UBIEEE/micromouse_pcb_team_2023/hardware/pcb/micromouse.kicad_pcb

## KiCad design hardware/pcb/micromouse.kicad_pcb (2024-01-07)

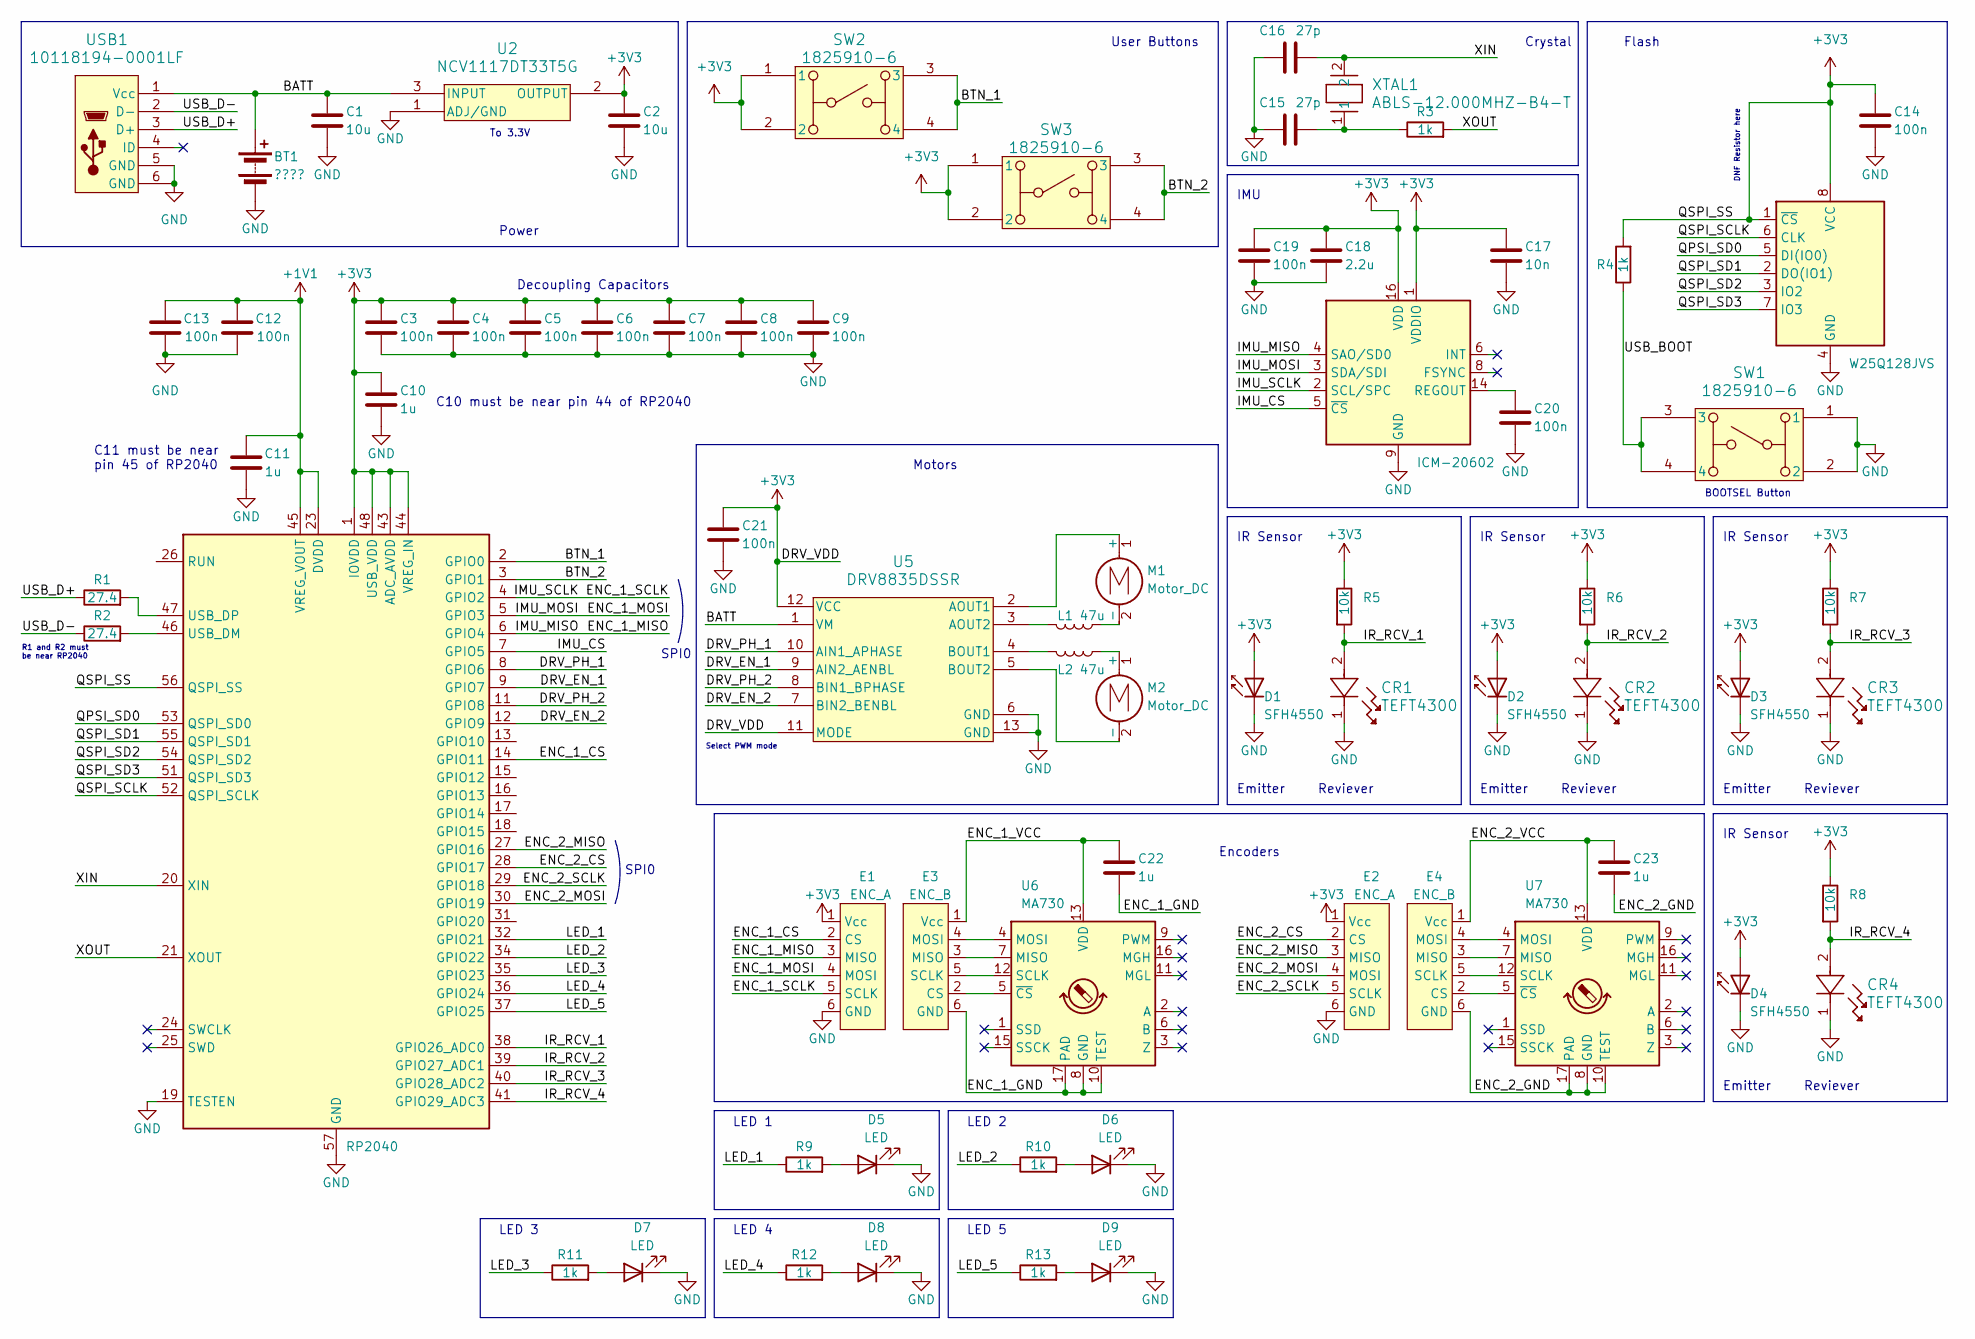
[picture p1: schematic micromouse.kicad_sch]

Parts:
BT1: ????; CONN_B2B-ZRLFSN_JST
C1, C2: 10u; CAP_GRM21_MUR
C3, C4, C5, C6, C7, C8, C9, C12, C13, C14, C19, C20, C21: 100n; CAP_GRM155_MUR
C10, C11, C22, C23: 1u; CAP_GRM155_MUR
C15, C16: 27p; CAP_GCM155_MUR
C17: 10n; CAP_GRM1885_1P6XP8_MUR
C18: 2.2u; CAP_GRM155_MUR
CR1, CR2, CR3, CR4: TEFT4300
D1, D2, D3, D4: SFH4550
D5, D6, D7, D8, D9: LED; LED_LTST-C191_LTO
E1: ENC_A; ENC_1_A
E2: ENC_A; ENC_2_A
E3: ENC_B; ENC_1_B
E4: ENC_B; ENC_2_B
L1, L2: 47u; IND_BOURNS_SRR4028
M1, M2: Motor_DC; CONN_B2B-ZRLFSN_JST
R1, R2: 27.4; RES_RC0402_YAG
R3, R4, R9, R10, R11, R12, R13: 1k; RES_RC0402_YAG
R5, R6, R7, R8: 10k; RES_RC0402_YAG
SW1, SW2, SW3: 1825910-6; SW4_1825910-B_TEC
U1: RP2040; QFN-56-1EP_7x7mm_P0.4mm_EP3.2x3.2mm
U2: NCV1117DT33T5G; DPAK-3_ONS
U3: W25Q128JVS; SOIC-8_5.23x5.23mm_P1.27mm
U4: ICM-20602; LGA-16_3x3mm_P0.5mm_LayoutBorder3x5y
U5: DRV8835DSSR; DSS0012A
U6, U7: MA730; QFN-16-1EP_3x3mm_P0.5mm_EP1.75x1.75mm
USB1: 10118194-0001LF; CONN_10118194-0001LF_AMP
XTAL1: ABLS-12.000MHZ-B4-T; XTAL_ABLS_ABR

Connections:
+1V1: C11.2, C12.2, C13.2, U1.23 (DVDD), U1.45 (VREG_VOUT), U1.50 (DVDD)
+3V3: C2.1, C3.1, C4.1, C5.1, C6.1, C7.1, C8.1, C9.1, C10.1, C14.1, C17.1, C18.1, C19.1, C21.1, D1.2 (A), D2.2 (A), D3.2 (A), D4.2 (A), E1.1 (Vcc), E2.1 (Vcc), R4.2, R5.1, R6.1, R7.1, R8.1, SW2.1, SW2.2, SW3.1, SW3.2, U1.1 (IOVDD), U1.10 (IOVDD), U1.22 (IOVDD), U1.33 (IOVDD), U1.42 (IOVDD), U1.43 (ADC_AVDD), U1.44 (VREG_IN), U1.48 (USB_VDD), U1.49 (IOVDD), U1.56 (QSPI_SS), U2.2 (OUTPUT), U3.1 (~CS), U3.8 (VCC), U4.1 (VDDIO), U4.16 (VDD), U5.11 (MODE), U5.12 (VCC)
/BATT: BT1.1 (+), C1.1, U2.3 (INPUT), U5.1 (VM), USB1.1 (Vcc)
/BTN_1: SW2.3, SW2.4, U1.2 (GPIO0)
/BTN_2: SW3.3, SW3.4, U1.3 (GPIO1)
/DRV_EN_1: U1.9 (GPIO7), U5.9 (AIN2_AENBL)
/DRV_EN_2: U1.12 (GPIO9), U5.7 (BIN2_BENBL)
/DRV_PH_1: U1.8 (GPIO6), U5.10 (AIN1_APHASE)
/DRV_PH_2: U1.11 (GPIO8), U5.8 (BIN1_BPHASE)
/ENC_1_CS: E1.2 (CS), U1.14 (GPIO11)
/ENC_1_GND: C22.2, E3.6 (GND), U6.8 (GND), U6.10 (TEST), U6.17 (PAD)
/ENC_1_MISO: E1.3 (MISO), U1.6 (GPIO4), U4.4 (SAO/SD0)
/ENC_1_MOSI: E1.4 (MOSI), U1.5 (GPIO3), U4.3 (SDA/SDI)
/ENC_1_SCLK: E1.5 (SCLK), U1.4 (GPIO2), U4.2 (SCL/SPC)
/ENC_1_VCC: C22.1, E3.1 (Vcc), U6.13 (VDD)
/ENC_2_CS: E2.2 (CS), U1.28 (GPIO17)
/ENC_2_GND: C23.2, E4.6 (GND), U7.8 (GND), U7.10 (TEST), U7.17 (PAD)
/ENC_2_MISO: E2.3 (MISO), U1.27 (GPIO16)
/ENC_2_MOSI: E2.4 (MOSI), U1.30 (GPIO19)
/ENC_2_SCLK: E2.5 (SCLK), U1.29 (GPIO18)
/ENC_2_VCC: C23.1, E4.1 (Vcc), U7.13 (VDD)
/IMU_CS: U1.7 (GPIO5), U4.5 (~CS)
/IR_RCV_1: CR1.2, R5.2, U1.38 (GPIO26_ADC0)
/IR_RCV_2: CR2.2, R6.2, U1.39 (GPIO27_ADC1)
/IR_RCV_3: CR3.2, R7.2, U1.40 (GPIO28_ADC2)
/IR_RCV_4: CR4.2, R8.2, U1.41 (GPIO29_ADC3)
/LED_1: R9.1, U1.32 (GPIO21)
/LED_2: R10.1, U1.34 (GPIO22)
/LED_3: R11.1, U1.35 (GPIO23)
/LED_4: R12.1, U1.36 (GPIO24)
/LED_5: R13.1, U1.37 (GPIO25)
/QPSI_SD0: U1.53 (QSPI_SD0), U3.5 (DI(IO0))
/QSPI_SCLK: U1.52 (QSPI_SCLK), U3.6 (CLK)
/QSPI_SD1: U1.55 (QSPI_SD1), U3.2 (DO(IO1))
/QSPI_SD2: U1.54 (QSPI_SD2), U3.3 (IO2)
/QSPI_SD3: U1.51 (QSPI_SD3), U3.7 (IO3)
/USB_BOOT: R4.1, SW1.3, SW1.4
/USB_D+: R1.1, USB1.3 (D+)
/USB_D-: R2.1, USB1.2 (D-)
/XIN: C16.2, U1.20 (XIN), XTAL1.2
/XOUT: R3.2, U1.21 (XOUT)
GND: BT1.2 (-), C1.2, C2.2, C3.2, C4.2, C5.2, C6.2, C7.2, C8.2, C9.2, C10.2, C11.1, C12.1, C13.1, C14.2, C15.1, C16.1, C17.2, C18.2, C19.2, C20.2, C21.2, CR1.1, CR2.1, CR3.1, CR4.1, D1.1 (K), D2.1 (K), D3.1 (K), D4.1 (K), D5.1 (K), D6.1 (K), D7.1 (K), D8.1 (K), D9.1 (K), E1.6 (GND), E2.6 (GND), SW1.1, SW1.2, U1.19 (TESTEN), U1.57 (GND), U2.1 (ADJ/GND), U3.4 (GND), U4.9 (GND), U4.10 (GND), U4.11 (GND), U4.12 (GND), U4.13 (GND), U4.15 (GND), U5.6 (GND), U5.13 (GND), USB1.5 (GND), USB1.6 (GND)
unnamed: C15.2, R3.1, XTAL1.1
unnamed: D5.2 (A), R9.2
unnamed: D6.2 (A), R10.2
unnamed: D7.2 (A), R11.2
unnamed: D8.2 (A), R12.2
unnamed: D9.2 (A), R13.2
unnamed: E3.2 (CS), U6.5 (~CS)
unnamed: E3.3 (MISO), U6.7 (MISO)
unnamed: E3.4 (MOSI), U6.4 (MOSI)
unnamed: E3.5 (SCLK), U6.12 (SCLK)
unnamed: E4.2 (CS), U7.5 (~CS)
unnamed: E4.3 (MISO), U7.7 (MISO)
unnamed: E4.4 (MOSI), U7.4 (MOSI)
unnamed: E4.5 (SCLK), U7.12 (SCLK)
unnamed: M1.1 (+), U5.2 (AOUT1)
unnamed: L1.1, M1.2 (-)
unnamed: L2.1, M2.1 (+)
unnamed: M2.2 (-), U5.5 (BOUT2)
unnamed: R2.2, U1.46 (USB_DM)
unnamed: R1.2, U1.47 (USB_DP)
unnamed: C20.1, U4.14 (REGOUT)
unnamed: L1.2, U5.3 (AOUT2)
unnamed: L2.2, U5.4 (BOUT1)

Notes on the sheet:
Decoupling Capacitors
User Buttons
Emitter
Reviever
LED 4
LED 3
Flash
Crystal
DNF Resistor here
Select PWM mode
Power
SPI0
R1 and R2 must be near RP2040
IR Sensor
BOOTSEL Button
Encoders
C11 must be near pin 45 of RP2040
To 3.3V
LED 5
LED 1
C10 must be near pin 44 of RP2040
LED 2
IMU
Motors

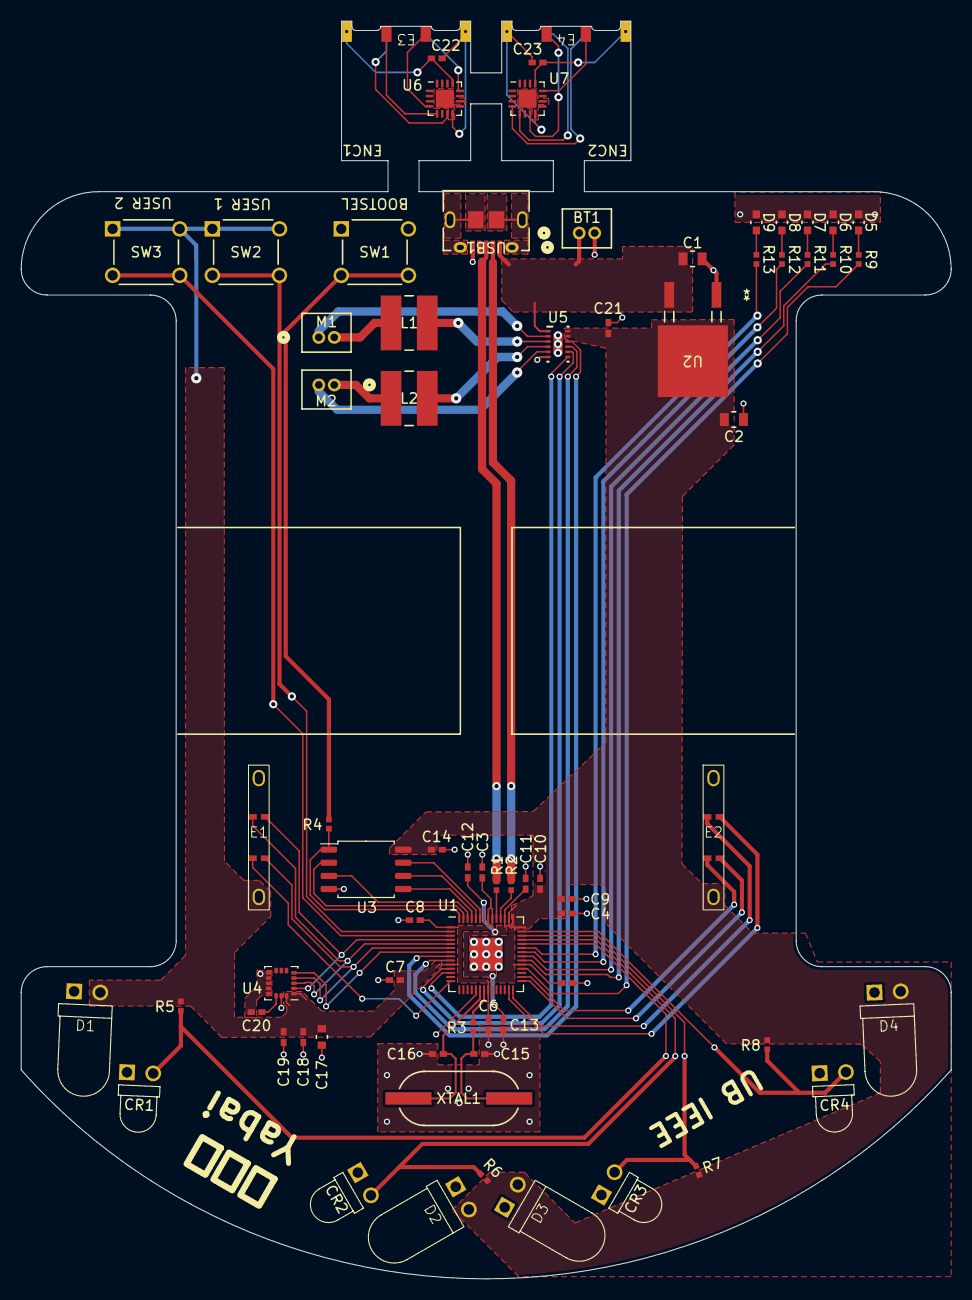
[picture p2: board micromouse.kicad_pcb from above]

Board: 2 copper layers, 90.0 x 121.7 mm, 70 parts (0 on the bottom side), 65 nets.
