UBIEEE/micromouse_pcb_team_2023/(commit log)

2023-10-21 Initial work on PCB schematic
    [micromouse.kicad_pcb, micromouse.kicad_sch]
2023-10-25 Started work on PCB, still got a lot of work to do
    [micromouse.kicad_pcb, micromouse.kicad_sch]
2023-10-27 Lots of PCB work
    [micromouse.kicad_pcb, micromouse.kicad_sch]
2023-11-07 PCB updates
    [micromouse.kicad_pcb, micromouse.kicad_sch]
2023-11-08 Removed extra silkscreen drawings and stuff on the side
    [micromouse.kicad_pcb]
2023-11-26 Initial code for drivetrain and MA730 encoders
2023-11-26 Fixed some DRC errors, worked on encoder placement
    [micromouse.kicad_pcb, micromouse.kicad_sch]
2023-11-30 Updated hardware IO, worked on ICM20602 and MA730 hardware drivers, drivetrain, etc.
2023-12-01 Created PWM hardware driver for DRV8835 motor driver, cleanup, etc.
2023-12-01 Created test programs for imu and encoders
2024-01-07 Final PCB updates??
    [micromouse.kicad_pcb, micromouse.kicad_sch]
